icruzat1/Proyecto3-Arqui/config/requirements-macos-arm64.lock.txt

anyio==4.15.1
certifi==2026.10.23
ciel==2.6.1
click==8.2.1
cloup==3.1.0
Deprecated==1.3.1
h11==0.16.0
httpcore==1.0.9
httpx==0.28.1
idna==3.20
klayout==0.30.12
librelane==3.0.17
lln-libparse==0.56.0
lxml==6.1.3
markdown-it-py==4.2.0
mdurl==0.1.2
packaging==26.3
pcpp==1.30
psutil==7.2.2
Pygments==2.21.0
PyYAML==6.0.3
RapidFuzz==3.14.6
rich==15.0.0
semver==3.1.0
typing_extensions==4.16.0
wheel==0.48.0
wrapt==2.5.1
yamlcore==0.0.4
zstandard==0.25.0
