icruzat1/Proyecto3-Arqui/evidence/layout_captures/antenna_stage6_100ns_u40_targeted_b/overview.png

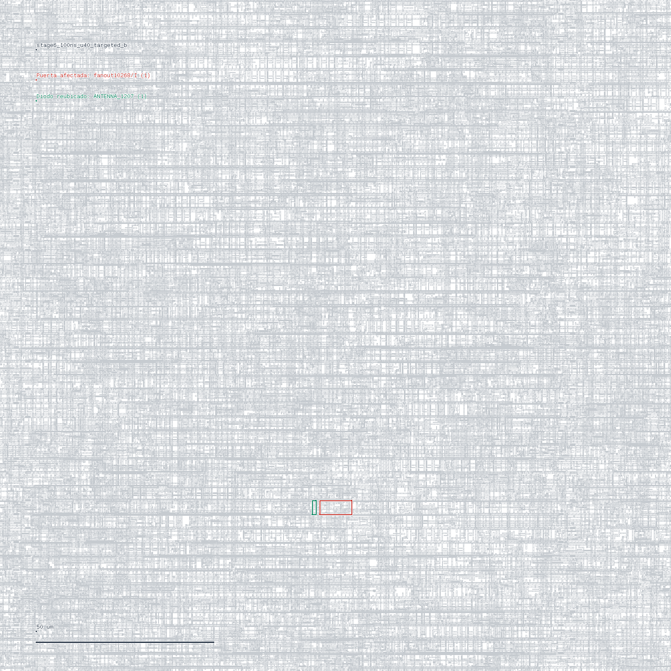
evidence/layout_captures/antenna_stage6_100ns_u40_targeted_b/overview.png
