icruzat1/Proyecto3-Arqui/evidence/layout_captures/entrega_2x2/A_blocks.png

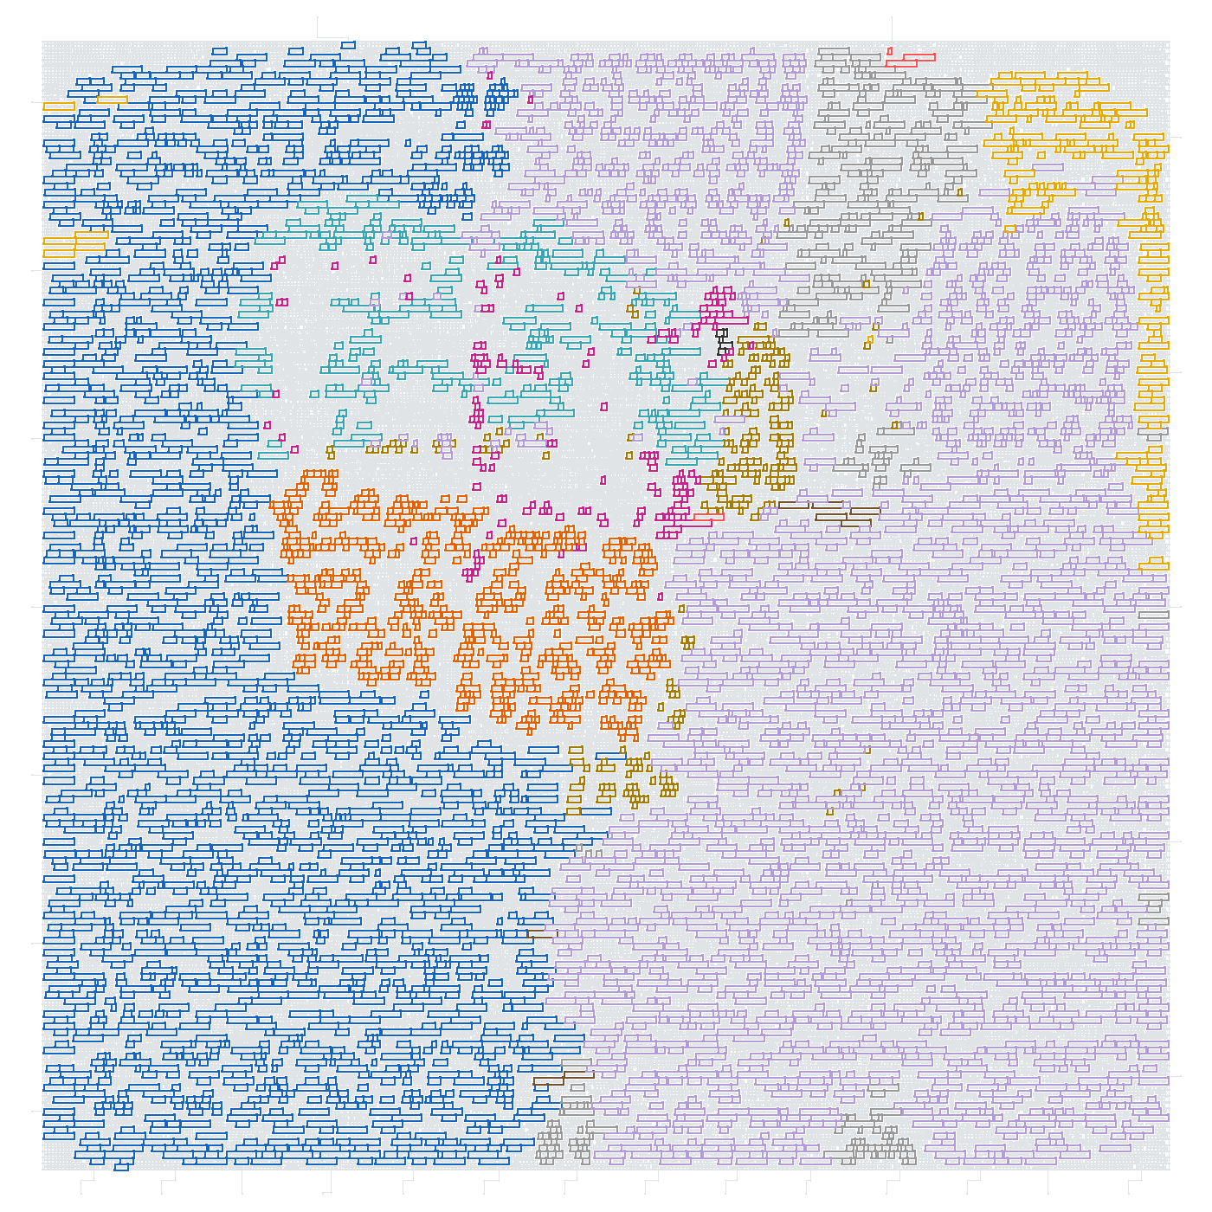
evidence/layout_captures/entrega_2x2/A_blocks.png
