icruzat1/Proyecto3-Arqui/evidence/layout_captures/stage6_100ns_u40_final_a/counter.png

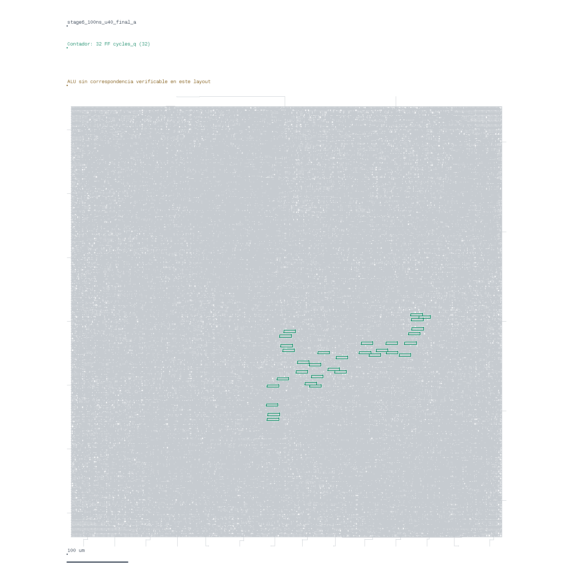
evidence/layout_captures/stage6_100ns_u40_final_a/counter.png
