icruzat1/Proyecto3-Arqui/evidence/layout_captures/stage6_100ns_u40_final_a/overview.png

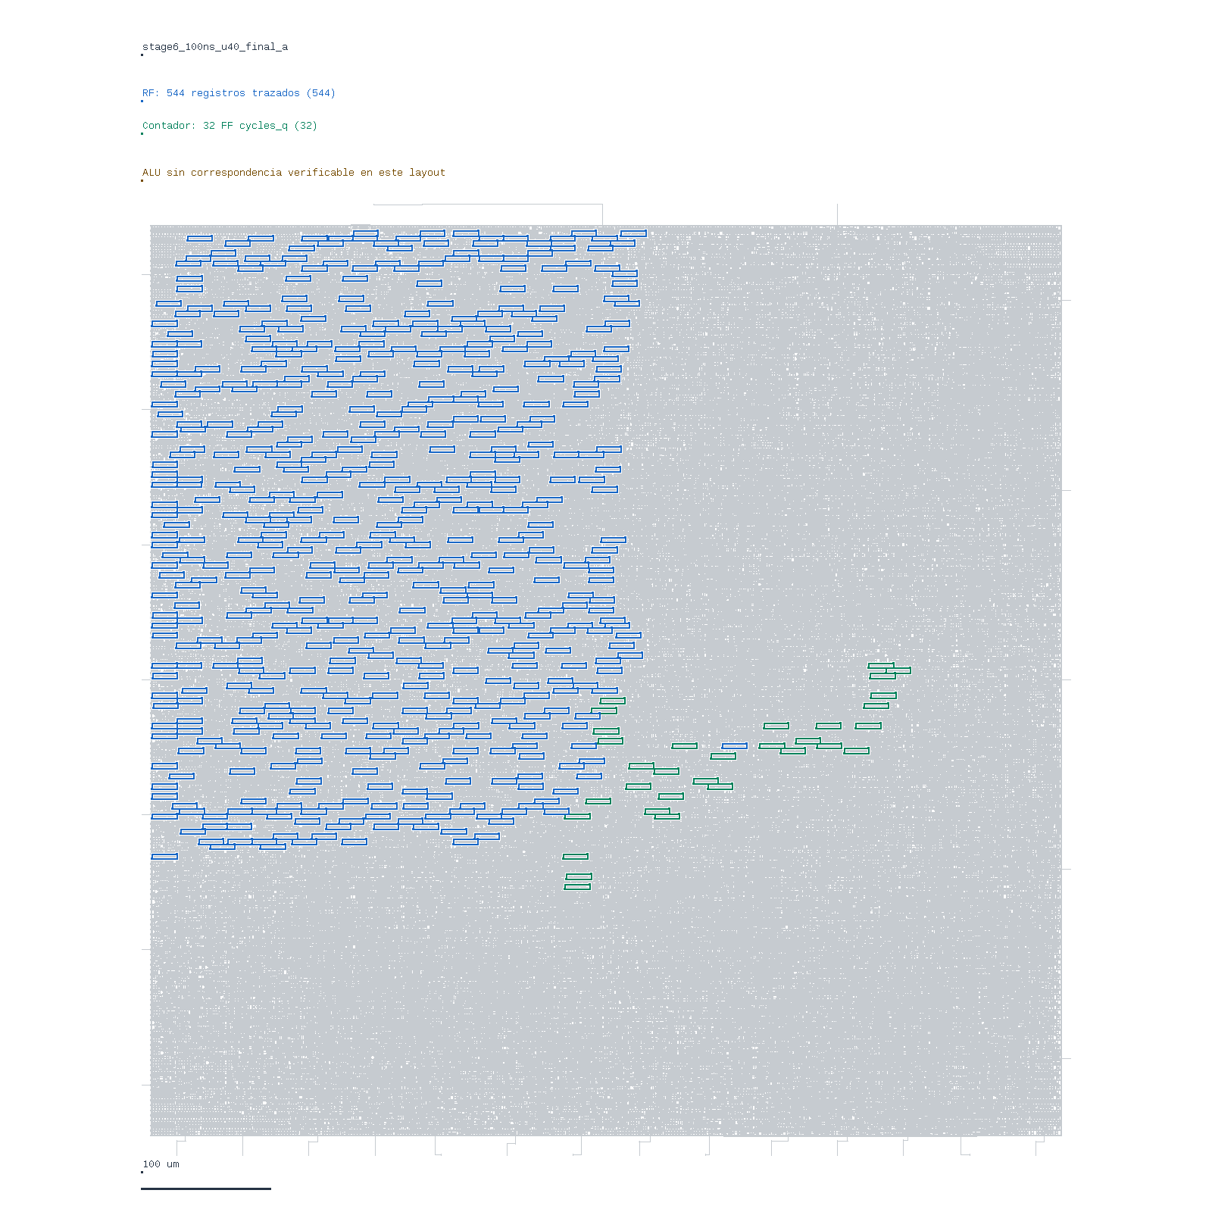
evidence/layout_captures/stage6_100ns_u40_final_a/overview.png
