icruzat1/Proyecto3-Arqui/evidence/layout_captures/stage7_trace_physical_candidate_a/overview.png

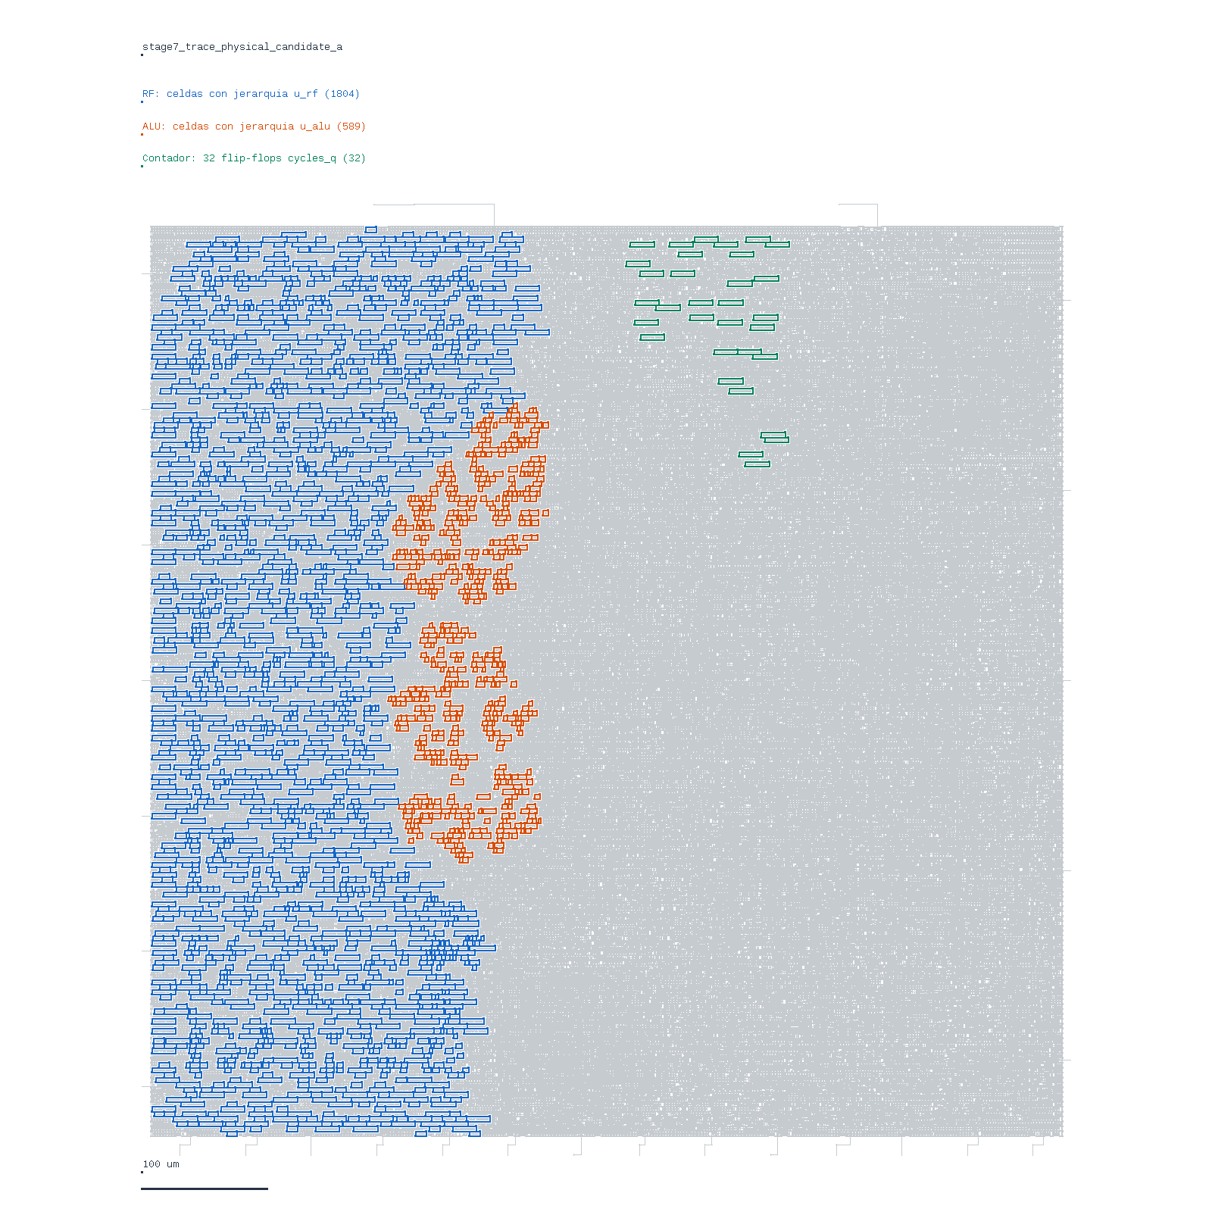
evidence/layout_captures/stage7_trace_physical_candidate_a/overview.png
