icruzat1/Proyecto3-Arqui/evidence/layout_captures/stage8_t100_u40_b/rf.png

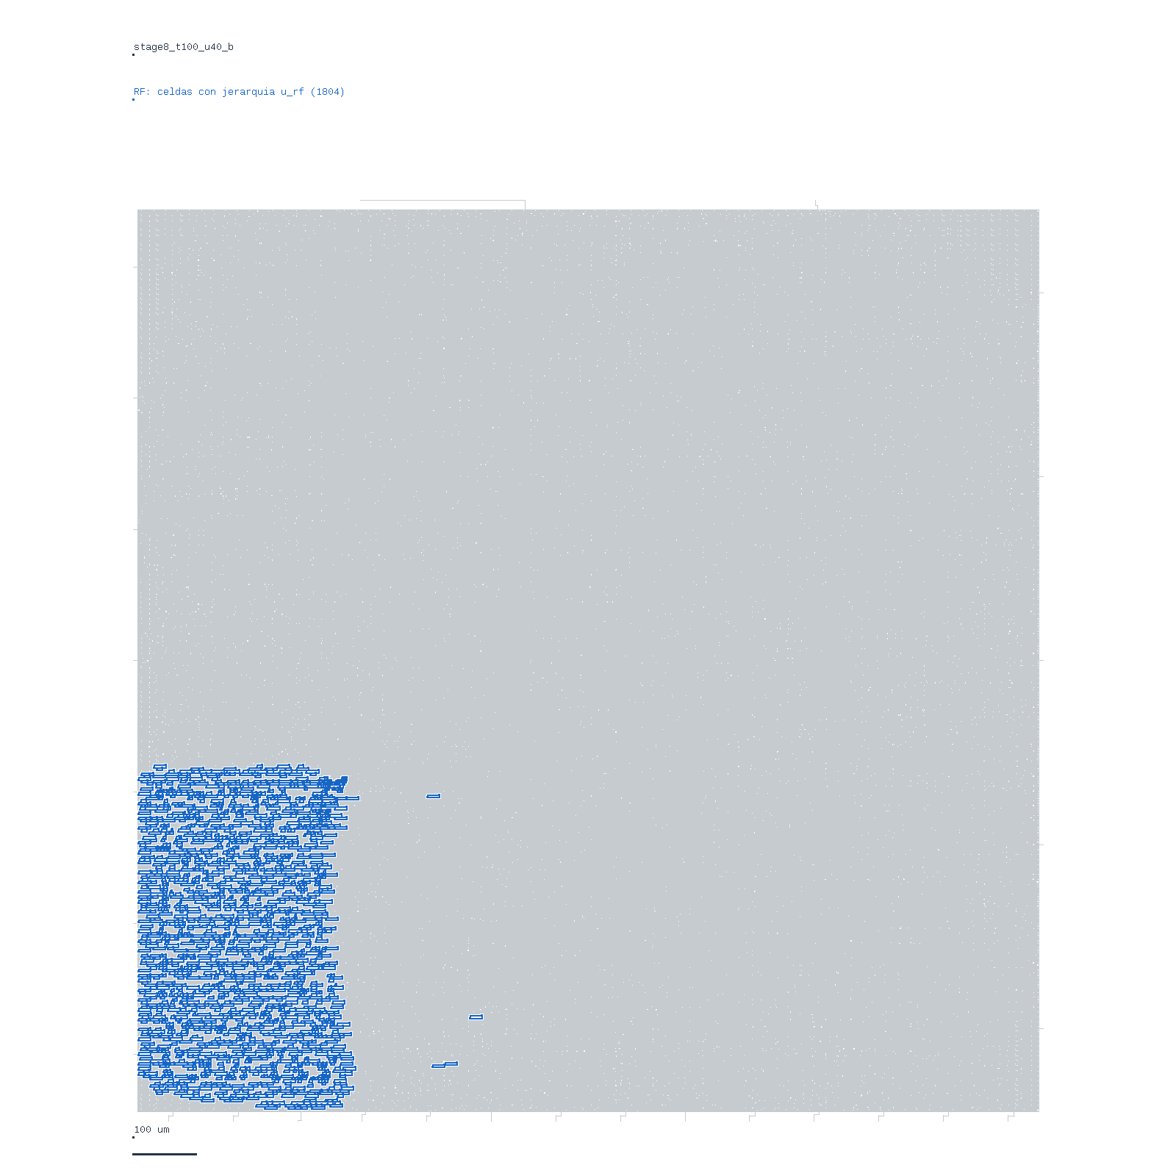
evidence/layout_captures/stage8_t100_u40_b/rf.png
