icruzat1/Proyecto3-Arqui/evidence/layout_captures/stage8_t100_u50_a/counter.png

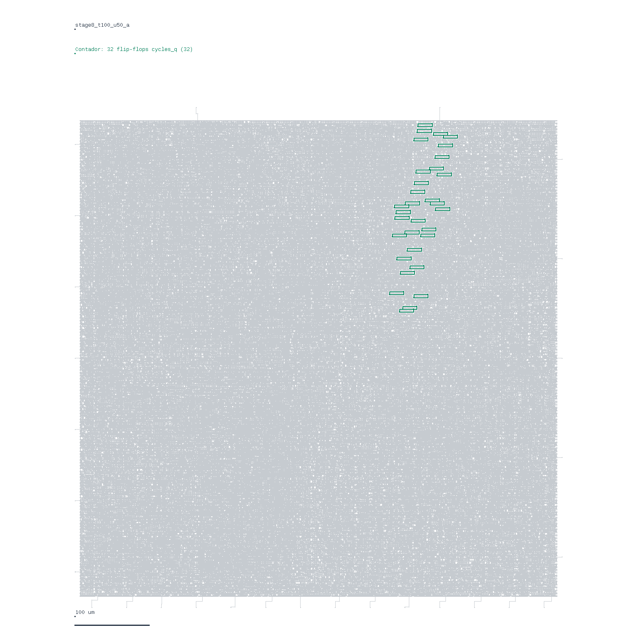
evidence/layout_captures/stage8_t100_u50_a/counter.png
