icruzat1/Proyecto3-Arqui/evidence/layout_captures/stage12_electrical_route_b_blocks/decode.png

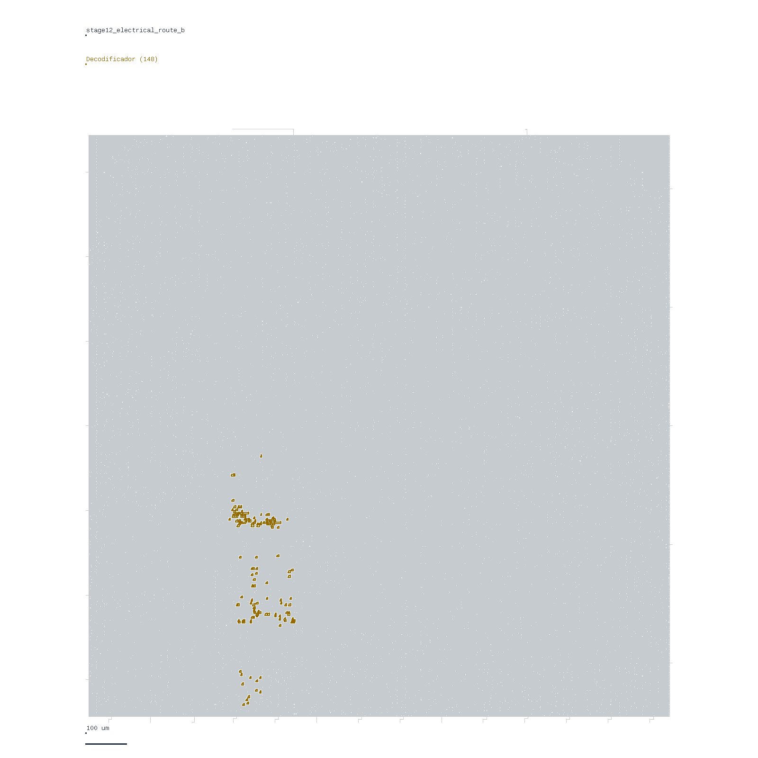
evidence/layout_captures/stage12_electrical_route_b_blocks/decode.png
