icruzat1/Proyecto3-Arqui/evidence/layout_captures/stage13_final_traceable_a_blocks/alu.png

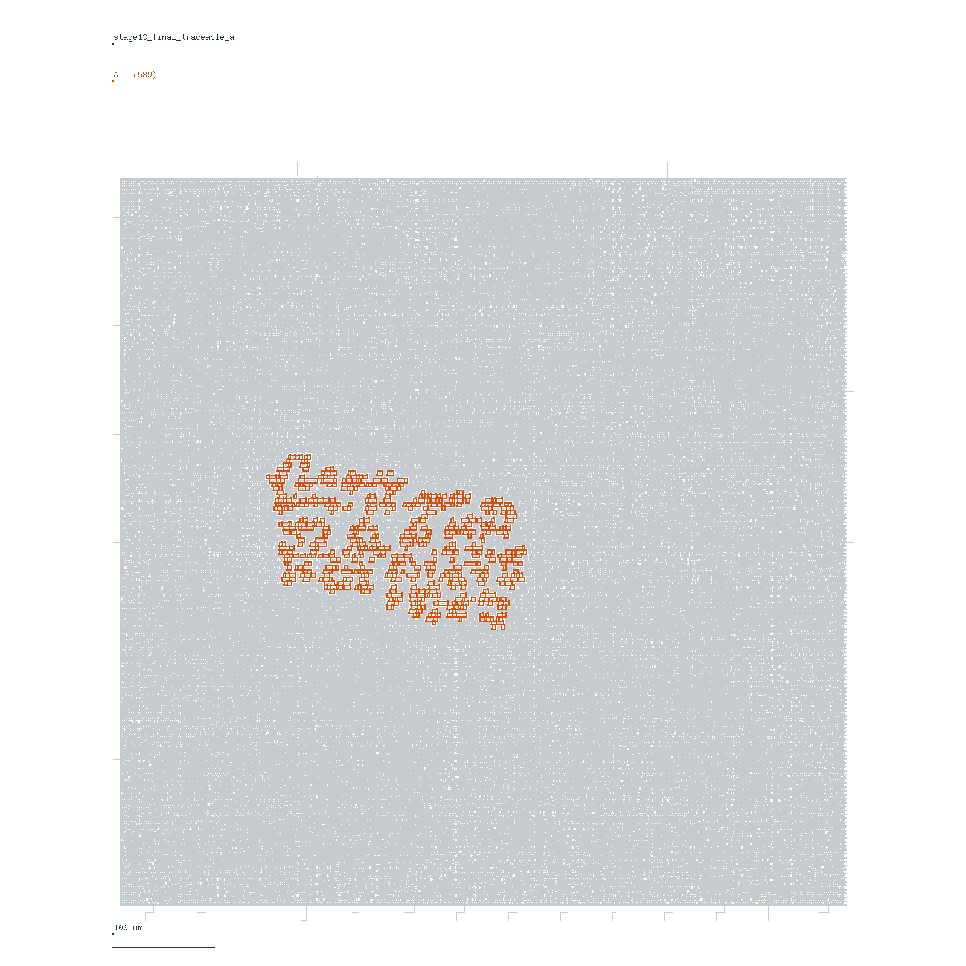
evidence/layout_captures/stage13_final_traceable_a_blocks/alu.png
