icruzat1/Proyecto3-Arqui/experiments/rtl_decode_pipeline/espino_id_stage.v

// Copyright 2026 Universidad de los Andes.
// Licensed under the Solderpad Hardware License, Version 0.51 (the "License");
// you may not use this file except in compliance with the License.
// SPDX-License-Identifier: SHL-0.51
//
// Course: Arquitectura de Computadores (2026)
// 
// Authors:
// - Nicolás Villegas <navillegas@miuandes.cl>

module espino_id_stage (
  input  wire        clk_i,
  input  wire        rst_ni,

  input  wire        instr_valid_i,
  input  wire [31:0] instr_rdata_i,
  input  wire [31:0] pc_id_i,
  input  wire        stall_i,

  // Register file
  output wire [3:0]  rf_raddr_a_o,
  output wire [3:0]  rf_raddr_b_o,
  input  wire [31:0] rf_rdata_a_i,
  input  wire [31:0] rf_rdata_b_i,
  output wire [3:0]  rf_waddr_o,
  output reg  [31:0] rf_wdata_o,
  output wire        rf_we_o,

  // LSU control
  output wire        lsu_req_o,
  output wire        lsu_we_o,
  output wire [1:0]  lsu_type_o,
  output wire        lsu_sign_o,
  output wire [31:0] lsu_addr_o,
  output wire [31:0] lsu_wdata_o,
  input  wire [31:0] lsu_rdata_i,

  // Control transfer
  output wire        branch_taken_o,
  output wire        jump_o,
  output wire [31:0] pc_target_o,

  // Sync-read handshake to controller
  output wire        rf_ready_o,

  output wire        illegal_insn_o
);

  localparam [1:0] OP_A_PC   = 2'd1;
  localparam [1:0] OP_A_ZERO = 2'd2;
  localparam       OP_B_IMM  = 1'b1;
  localparam [1:0] WD_LSU    = 2'd1;
  localparam [1:0] WD_PC4    = 2'd2;

  // Register addresses
  assign rf_raddr_a_o = instr_rdata_i[18:15];
  assign rf_raddr_b_o = instr_rdata_i[23:20];
  assign rf_waddr_o   = instr_rdata_i[10:7];

  // ---- synchronous-read wait FSM ----
  reg  ops_valid_q;
  wire advance = ~stall_i;
  always @(posedge clk_i or negedge rst_ni) begin
    if (!rst_ni)      ops_valid_q <= 1'b0;
    else if (advance) ops_valid_q <= 1'b0;
    else              ops_valid_q <= 1'b1;
  end
  assign rf_ready_o = ops_valid_q;

  // Experimental retiming into the existing synchronous-RF wait cycle.
  wire [3:0] alu_operator_raw;
  reg  [3:0] alu_operator;
  wire [1:0] alu_op_a_sel_raw;
  reg  [1:0] alu_op_a_sel;
  wire alu_op_b_sel_raw;
  reg  alu_op_b_sel;
  wire [31:0] imm_operand_raw;
  reg  [31:0] imm_operand;
  wire [31:0] imm_target_raw;
  reg  [31:0] imm_target;
  wire rf_we_dec_raw;
  reg  rf_we_dec;
  wire [1:0] rf_wd_sel_raw;
  reg  [1:0] rf_wd_sel;
  wire is_branch_raw;
  reg  is_branch;
  wire is_jal_raw;
  reg  is_jal;
  wire is_jalr_raw;
  reg  is_jalr;
  wire lsu_req_dec_raw;
  reg  lsu_req_dec;
  wire lsu_we_dec_raw;
  reg  lsu_we_dec;
  wire [1:0] lsu_type_dec_raw;
  reg  [1:0] lsu_type_dec;
  wire lsu_sign_dec_raw;
  reg  lsu_sign_dec;

  espino_decoder u_decoder (
    .instr_i        (instr_rdata_i),
    .illegal_insn_o (illegal_insn_o),
    .alu_operator_o (alu_operator_raw),
    .alu_op_a_sel_o (alu_op_a_sel_raw),
    .alu_op_b_sel_o (alu_op_b_sel_raw),
    .imm_operand_o  (imm_operand_raw),
    .imm_target_o   (imm_target_raw),
    .rf_we_o        (rf_we_dec_raw),
    .rf_wd_sel_o    (rf_wd_sel_raw),
    .is_branch_o    (is_branch_raw),
    .is_jal_o       (is_jal_raw),
    .is_jalr_o      (is_jalr_raw),
    .lsu_req_o      (lsu_req_dec_raw),
    .lsu_we_o       (lsu_we_dec_raw),
    .lsu_type_o     (lsu_type_dec_raw),
    .lsu_sign_o     (lsu_sign_dec_raw)
  );

  // Whenever ops_valid_q is true, the previous cycle was stalled; the
  // memory therefore held instr_rdata_i, so these controls match that
  // instruction and the RF operands captured on the same edge.
  // Idle-cycle combinational values may differ; commits/requests cannot.
  always @(posedge clk_i or negedge rst_ni) begin
    if (!rst_ni) begin
      alu_operator <= 4'd0;
      alu_op_a_sel <= 2'd0;
      alu_op_b_sel <= 1'b1;
      imm_operand <= 32'b0;
      imm_target <= 32'b0;
      rf_we_dec <= 1'b0;
      rf_wd_sel <= 2'd0;
      is_branch <= 1'b0;
      is_jal <= 1'b0;
      is_jalr <= 1'b0;
      lsu_req_dec <= 1'b0;
      lsu_we_dec <= 1'b0;
      lsu_type_dec <= 2'd2;
      lsu_sign_dec <= 1'b1;
    end else begin
      alu_operator <= alu_operator_raw;
      alu_op_a_sel <= alu_op_a_sel_raw;
      alu_op_b_sel <= alu_op_b_sel_raw;
      imm_operand <= imm_operand_raw;
      imm_target <= imm_target_raw;
      rf_we_dec <= rf_we_dec_raw;
      rf_wd_sel <= rf_wd_sel_raw;
      is_branch <= is_branch_raw;
      is_jal <= is_jal_raw;
      is_jalr <= is_jalr_raw;
      lsu_req_dec <= lsu_req_dec_raw;
      lsu_we_dec <= lsu_we_dec_raw;
      lsu_type_dec <= lsu_type_dec_raw;
      lsu_sign_dec <= lsu_sign_dec_raw;
    end
  end

  // Operand muxes
  reg  [31:0] operand_a;
  wire [31:0] operand_b;
  always @* begin
    case (alu_op_a_sel)
      OP_A_PC:   operand_a = pc_id_i;
      OP_A_ZERO: operand_a = 32'b0;
      default:   operand_a = rf_rdata_a_i;
    endcase
  end
  assign operand_b = (alu_op_b_sel == OP_B_IMM) ? imm_operand : rf_rdata_b_i;

  wire [31:0] alu_result;
  wire        alu_cmp_result;
  espino_alu u_alu (
    .operator_i   (alu_operator),
    .operand_a_i  (operand_a),
    .operand_b_i  (operand_b),
    .result_o     (alu_result),
    .cmp_result_o (alu_cmp_result)
  );

  // LSU control
  assign lsu_req_o   = lsu_req_dec & instr_valid_i & ops_valid_q;
  assign lsu_we_o    = lsu_we_dec;
  assign lsu_type_o  = lsu_type_dec;
  assign lsu_sign_o  = lsu_sign_dec;
  assign lsu_addr_o  = alu_result;
  assign lsu_wdata_o = rf_rdata_b_i;

  // Control transfer
  assign branch_taken_o = is_branch & alu_cmp_result;
  assign jump_o         = is_jal | is_jalr;
  assign pc_target_o    = is_jalr ? (alu_result & ~32'h1)
                                  : (pc_id_i + imm_target);

  wire commit = instr_valid_i & ~stall_i;

  always @* begin
    case (rf_wd_sel)
      WD_LSU:  rf_wdata_o = lsu_rdata_i;
      WD_PC4:  rf_wdata_o = pc_id_i + 32'd4;
      default: rf_wdata_o = alu_result;
    endcase
  end

  assign rf_we_o = rf_we_dec & commit;

endmodule
