icruzat1/Proyecto3-Arqui/(commit log)

2026-10-29 Inicia Proyecto 3 con base FPGA portable y prueba de arranque
2026-10-29 Verifica Docker ARM64 y el flujo GF180MCU
2026-10-29 Actualiza el estado final del cuaderno de continuidad
2026-10-29 Integra el kit Etapa 5 y contrasta la documentación con el enunciado
2026-10-29 Adapta interfaz, reset y RF a ASIC y verifica síntesis genérica
    [asic_memory.v, asic_top.v, btn_sync.v, espino_id_stage.v, espino_register_file.v, pochoco_soc.v]
2026-10-29 Recalibra el juego a 10 MHz y verifica RTL y netlists A/B
2026-10-29 Mapea A/B a GF180 y documenta primer floorplan y timing pendiente
    [pin_order.cfg]
2026-10-31 Entrega final ASIC A/B a 10 MHz con documentación y evidencias seleccionadas
    [pin_order.cfg]
